BioroboticsLab/hiveopolis_dance_robot/README.md

# Hiveopolis Dance Robot

This will list the documents and files for constructing the bee robot.
