BioroboticsLab/hiveopolis_dance_robot/BeeRobot/Bee Robot (2022 Design)/Hardware(Mechanical)/Dummy/Description CAD files Robo Dummy.docx

Rounded End Dummy:

- Three files were included, namely bee-artificial_v5 v4.stl, .step, and .f3z (a fusion archive file).
- The .stl file can be used for 3d printing the specified dummy.
- Printing instructions:
  - The dummy is printed with flexible materials, namely TPU95 or other more flexible or rigid versions of this thermoplastic material.
  - The dummy should be printed with its body on the build plate for better results.

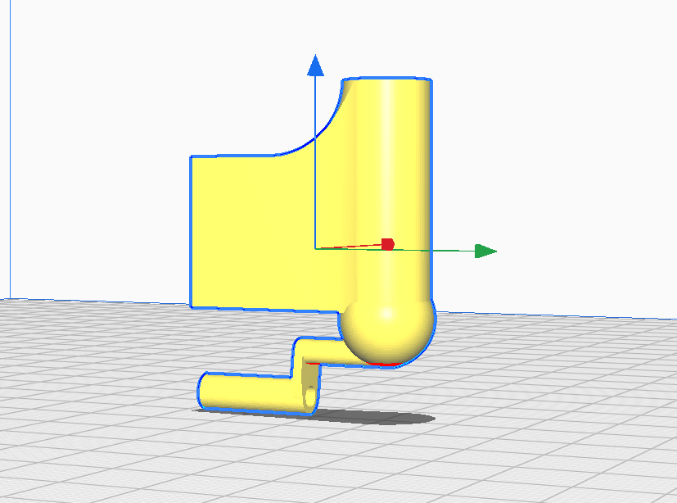
[picture p1: figure]

  - Tree support was seen as promising and easily detachable support.

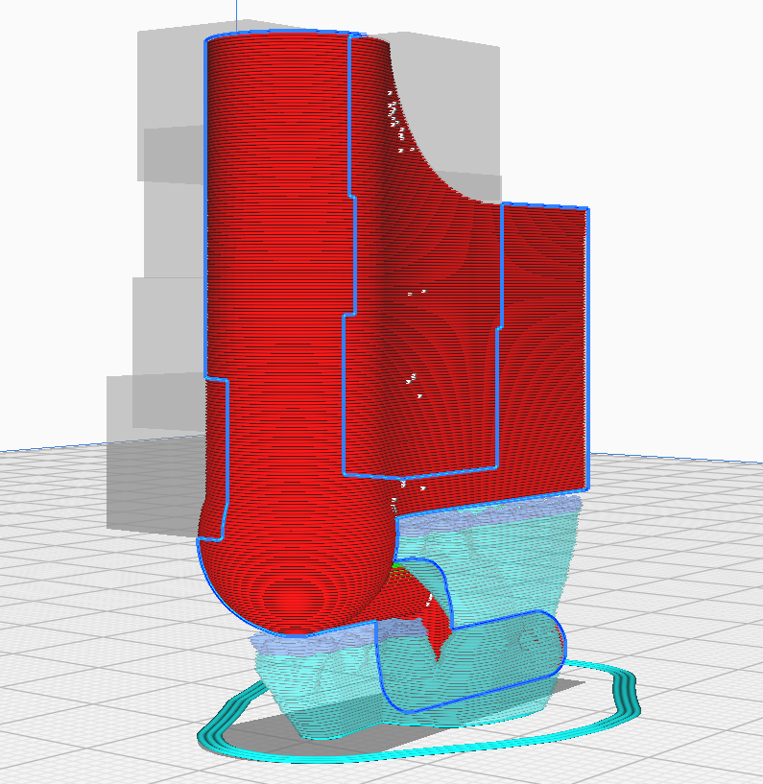
[picture p2: figure]

Flat End Dummy:

- Three files were included, namely bee-artificial_v6 v1.stl, .step, and .f3z (a fusion archive file).
- The .stl file can be used for 3d printing the specified dummy.
- Printing instructions:
  - The dummy is printed with flexible materials, namely TPU95 or other more flexible or rigid versions of this thermoplastic material.
