BioroboticsLab/hiveopolis_dance_robot/BeeRobot/Bee Robot (2022 Design)/Bill Materials Combined.xlsx

Qty | Short Description | Link | Seller | Used for
4 | Linear bearing LM8UU / SP DR 8 mm Suitable for: velleman K8200 LM8UU / SP | https://www.conrad.de/de/p/linearlager-lm8uu-sp-dr-8-mm-passend-fuer-velleman-k8200-lm8uu-sp-1013428.html | Conrad | Body
4 | Reely linear ball bearing inner diameter: 6 mm outer diameter: 12 mm | https://www.conrad.de/de/p/reely-linearkugellager-innen-durchmesser-6-mm-aussen-durchmesser-12-mm-221974.html | Conrad | Body
4 | Silver steel shaft Reely (Ø x L) 8 mm x 500 mm | https://www.conrad.de/de/p/silberstahl-welle-reely-x-l-8-mm-x-500-mm-237205.html | Conrad | Body
4 | Panasonic microswitch | https://www.conrad.de/de/p/panasonic-mikroschalter-asq10617j-30-v-dc-0-1-a-1-x-ein-ein-tastend-1-st-702264.html | Conrad | Body
3 | Silver steel shaft Reely (Ø x L) 6 mm x 500 mm | https://www.conrad.com/p/silver-steel-shaft-reely-x-l-6-mm-x-500-mm-237086 | Conrad | Body
20 | Kemet 100 nF cap | https://www.conrad.de/de/p/kemet-c322c104k5r5ta-keramik-kondensator-radial-bedrahtet-100-nf-50-v-10-l-x-b-x-h-5-08-x-3-18-x-5-84-mm-1-st-1420319.html | Conrad | Keypad
10 | Header 2 | https://www.conrad.de/de/p/econ-connect-buchsenleiste-standard-anzahl-reihen-1-polzahl-je-reihe-2-blg1x2-1-st-1492277.html | Conrad | Main Board
10 | Header 3 | https://www.conrad.de/de/p/econ-connect-buchsenleiste-standard-anzahl-reihen-1-polzahl-je-reihe-3-blg1x3-1-st-1492300.html | Conrad | Main Board
10 | Header 5 | https://www.conrad.de/de/p/econ-connect-buchsenleiste-standard-anzahl-reihen-1-polzahl-je-reihe-5-blg1x5-1-st-1492291.html | Conrad | Main Board
10 | Header 8 | https://www.conrad.de/de/p/econ-connect-buchsenleiste-standard-anzahl-reihen-1-polzahl-je-reihe-8-blg1x8-1-st-1492302.html | Conrad | Main Board
10 | Header 16 | https://www.conrad.de/de/p/econ-connect-buchsenleiste-standard-anzahl-reihen-1-polzahl-je-reihe-16-blg1x16-1-st-1492274.html | Conrad | Main Board
10 | Header 20 | https://www.conrad.de/de/p/econ-connect-buchsenleiste-standard-anzahl-reihen-1-polzahl-je-reihe-20-blg1x20-1-st-1492278.html | Conrad | Main Board
1 | ESP32-DEVKITC-32E | https://www.digikey.de/en/products/detail/espressif-systems/ESP32-DEVKITC-32E/12091810 | Digikey | Main Board
1 | ESP32-DEVKITC-32E | https://www.digikey.de/en/products/detail/espressif-systems/ESP32-DEVKITC-32E/12091810 | Digikey | Keypad
2 | DFR0555 | https://www.digikey.de/en/products/detail/dfrobot/DFR0555/9356340 | Digikey | Keypad
12 | 5511M1X | https://www.digikey.de/en/products/detail/e-switch/5511M1X/271586 | Digikey | Keypad
2 | Stepper LSA421 | https://en.nanotec.com/products/2792-lsa421s14-a-uiev-152 | Nanotec | Body
2 | CABLE-EH06 | https://en.nanotec.com/products/1393-zk-jst-ehr-6-05m-s-motor-cable-05m | Nanotec | Body
1 | LSNUT-AAAA-UECB – THREADED NUT | https://en.nanotec.com/products/2840-lsnut-aaaa-uecb-threaded-nut | Nanotec | Body
1 | LSNUT-AEAE-UIEV | https://en.nanotec.com/products/2800-lsnut-aeae-uiev-axial-anti-backlash-threaded-nut-with-helical-spring | Nanotec | Body
1 | NANOLUBE-50G – BEARING GREASE | https://en.nanotec.com/products/2389-nanolube-50g-bearing-grease | Nanotec | Body
1 | ENCODER CABLE NOE, 0.5M | https://en.nanotec.com/products/1216-zk-noe1-10-500-s-encoder-cable-noe-05m | Nanotec | Body
1 | LSA201S06-B-UECB-102 with encoder NOE1-05-B14 (5 mm) | https://en.nanotec.com/products/product-configurator/2849?cHash=9072cd3baa13280dc13a2a933e44916d | Nanotec | Body
1 | TEENSY LC H Teensy LC, USB, mit Header | https://www.reichelt.de/teensy-lc-usb-mit-header-teensy-lc-h-p318646.html?&nbc=1 | reichelt | Main Board
20 | AKL 349-02 Anschlussklemmensystem 2-pol, RM5,0 | https://www.reichelt.de/de/de/anschlussklemmensystem-2-pol-rm5-0-akl-349-02-p36665.html?nbc=1&r=1 | reichelt | Main Board
20 | SLGW 902 5 Stiftleiste, lötbar, 2-pol, RM 5,00 | https://www.reichelt.de/stiftleiste-loetbar-2-pol-rm-5-00-slgw-902-5-p159599.html?nbc=1 | reichelt | Main Board
20 | AKL 330-04 Wannenstecker für AKL 349, 4-pol, RM5,0 | https://www.reichelt.de/wannenstecker-fuer-akl-349-4-pol-rm5-0-akl-330-04-p36681.html | reichelt | Main Board
20 | AKL 349-04 Anschlussklemmensystem 4-pol, RM5,0 | https://www.reichelt.de/anschlussklemmensystem-4-pol-rm5-0-akl-349-04-p36667.html?nbc=1 | reichelt | Main Board
1 | Pololu 24V Step-Up/Step-Down Voltage Regulator S18V20F24 | https://www.exp-tech.de/module/spannungsregler/9318/pololu-24v-step-up/step-down-voltage-regulator-s18v20f24 | exptech | Main Board
3 | Pololu A4988 Stepper Motor Driver Carrier | https://www.exp-tech.de/motoren/motorsteuerung/schrittmotor-treiber/4795/pololu-a4988-stepper-motor-driver-carrier-black-edition | exptech | Main Board
1 | 5V 1A STEP-DOWN D24V10F5 POLOLU | https://www.exp-tech.de/module/spannungsregler/6268/pololu-5v-1a-step-down-voltage-regulator-d24v10f5 | exptech | Main Board
