BioroboticsLab/hiveopolis_dance_robot/AdditionalSetup/Hardware/LightandCameraMount/Mount_Raspberry_Pi_CameraFRONT.stl

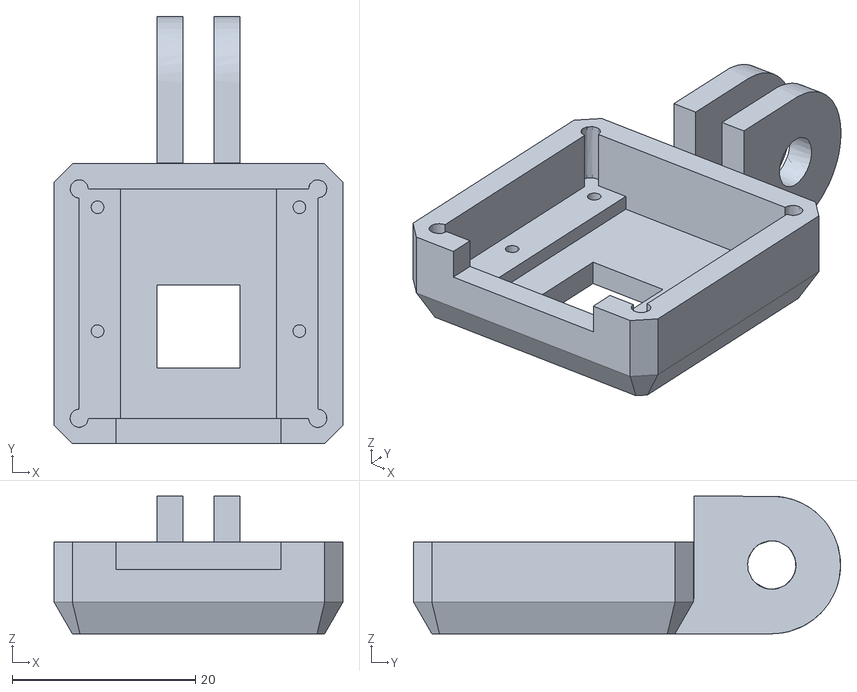
[picture p3: CAD file, 2023-08-09]
AdditionalSetup/Hardware/LightandCameraMount/Mount_Raspberry_Pi_CameraFRONT.stl
31.5 x 46.5 x 15.0
