BioroboticsLab/hiveopolis_dance_robot/AdditionalSetup/Hardware/Robot_ITEM_Fixture/3D_models/experment_setup/Robot_ITEM_Fixture.STEP

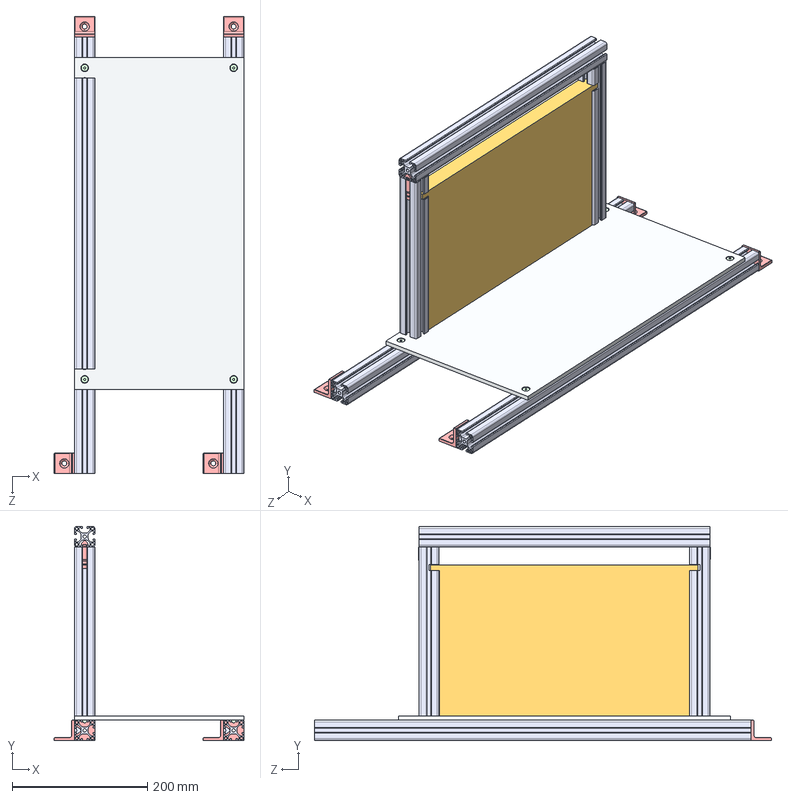
[picture p4: CAD file, 2023-08-09]
AdditionalSetup/Hardware/Robot_ITEM_Fixture/3D_models/experment_setup/Robot_ITEM_Fixture.STEP
280.0 x 316.0 x 675.0 mm
0041906_Profil_6_30x30_250 x 2
0041906_Profil_6_30x30_430
0041906_Profil_6_30x30_645 x 2
Al-Platte
Dummy
0067775_Winkel_6_30 x 4
0041971_Automatik-Verbindungssatz_6 x 2
0068094_Befestigungssatz_6 x 2
0068092_Befestigungssatz_5 x 4
