BioroboticsLab/hiveopolis_dance_robot/BeeRobot/Bee Robot (2022 Design)/Hardware(Mechanical)/Dance Robot Body/CAD files/carridgedesignv24_FRAME DESIGN_Part1.stl

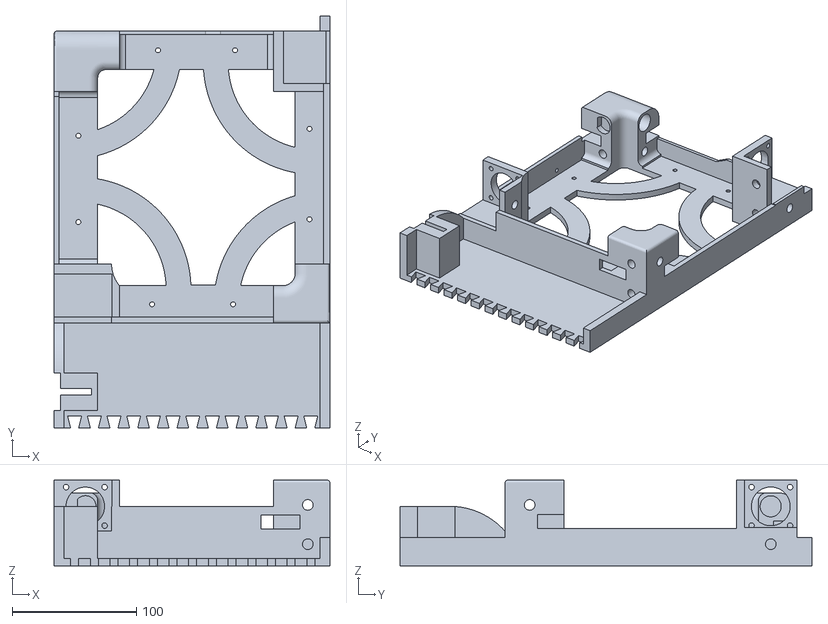
[picture p5: CAD file, 2023-08-09]
BeeRobot/Bee Robot (2022 Design)/Hardware(Mechanical)/Dance Robot Body/CAD files/carridgedesignv24_FRAME DESIGN_Part1.stl
222.0 x 331.5 x 69.1
