BioroboticsLab/hiveopolis_dance_robot/BeeRobot/Bee Robot (2022 Design)/Hardware(Mechanical)/Dummy/Flat End Dummy/bee_artificial_v6 v1.step

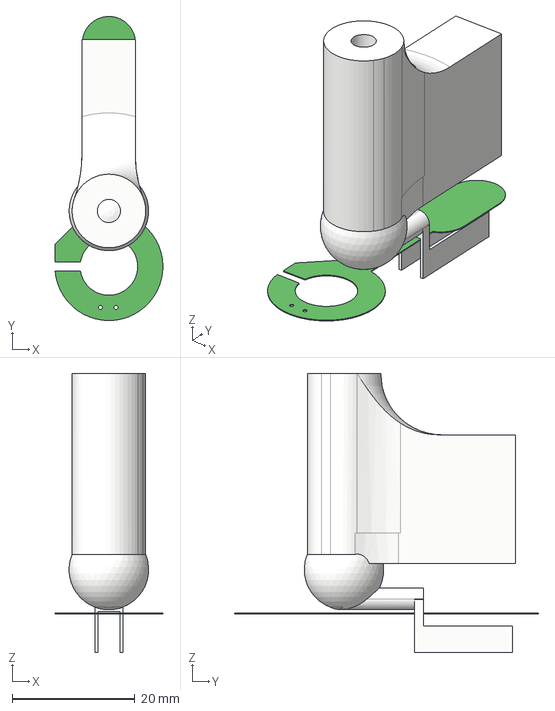
[picture p6: CAD file, 2023-08-09]
BeeRobot/Bee Robot (2022 Design)/Hardware(Mechanical)/Dummy/Flat End Dummy/bee_artificial_v6 v1.step
17.6 x 49.6 x 45.5 mm
