BioroboticsLab/hiveopolis_dance_robot/BeeRobot/Bee Robot (2022 Design)/Hardware(Mechanical)/Dummy/Rounded End Dummy/bee_artificial_v5 v4.step

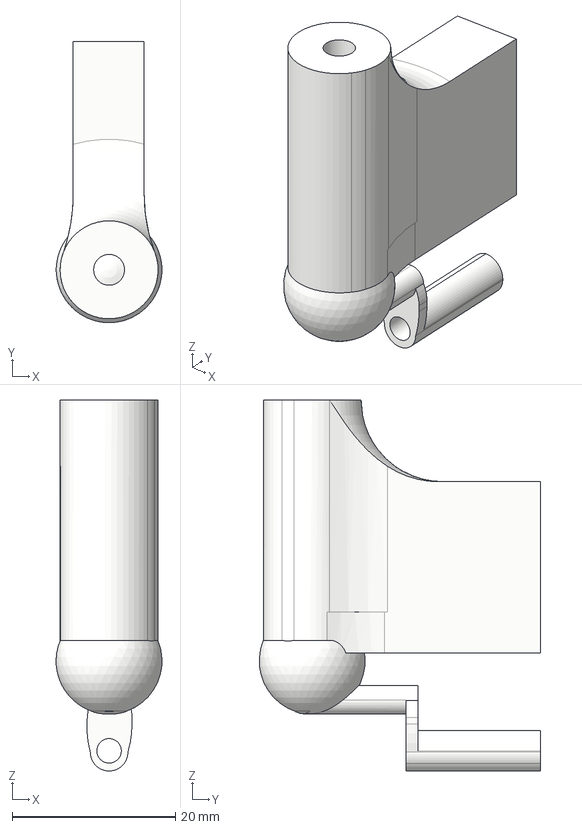
[picture p7: CAD file, 2023-08-09]
BeeRobot/Bee Robot (2022 Design)/Hardware(Mechanical)/Dummy/Rounded End Dummy/bee_artificial_v5 v4.step
13.0 x 34.5 x 45.5 mm
