BioroboticsLab/hiveopolis_dance_robot/AdditionalSetup/Hardware/LightandCameraMount/Mount_Arm_Straight_30mm.STL

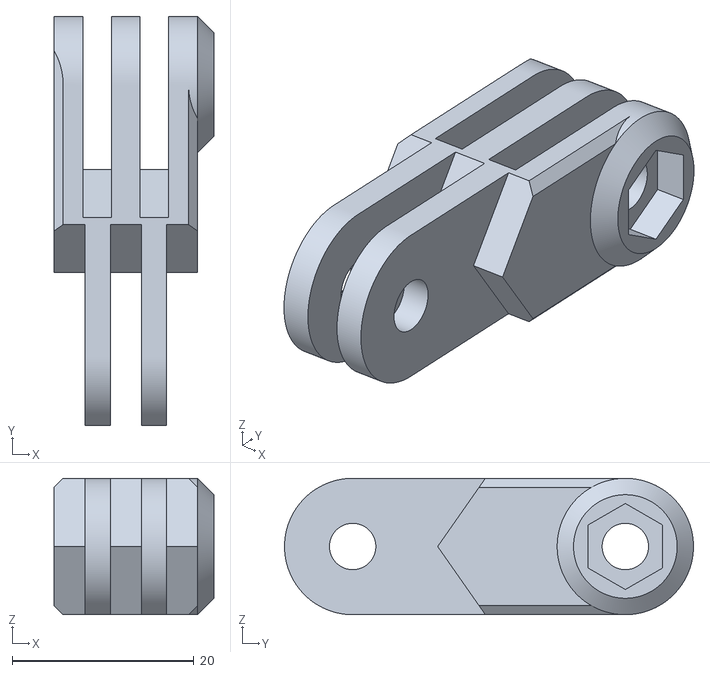
[picture p9: CAD file, 2023-08-09]
AdditionalSetup/Hardware/LightandCameraMount/Mount_Arm_Straight_30mm.STL
17.6 x 45.0 x 15.0
