BioroboticsLab/hiveopolis_dance_robot/BeeRobot/Bee Robot (2022 Design)/Hardware(Mechanical)/Dance Robot Body/CAD files/carridgedesignv24_FRAME DESIGN v14.step

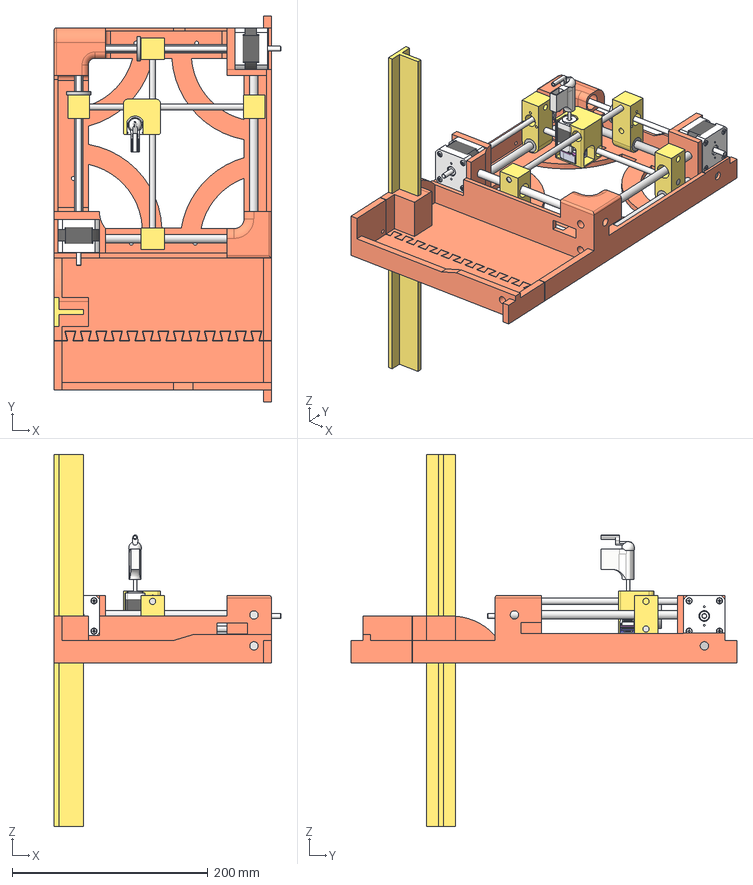
[picture p10: CAD file, 2023-08-09]
BeeRobot/Bee Robot (2022 Design)/Hardware(Mechanical)/Dance Robot Body/CAD files/carridgedesignv24_FRAME DESIGN v14.step
231.8 x 394.0 x 380.0 mm
LSA421S14-B-UIEV-152 x 2
LSNUT x 2
bee_artificial_v3
NOE1
LSA201S06-B-UECB-102
