BioroboticsLab/hiveopolis_dance_robot/BeeRobot/Bee Robot (2022 Design)/Hardware(Mechanical)/Keypad/CAD Files/pcb_keypad v5.step

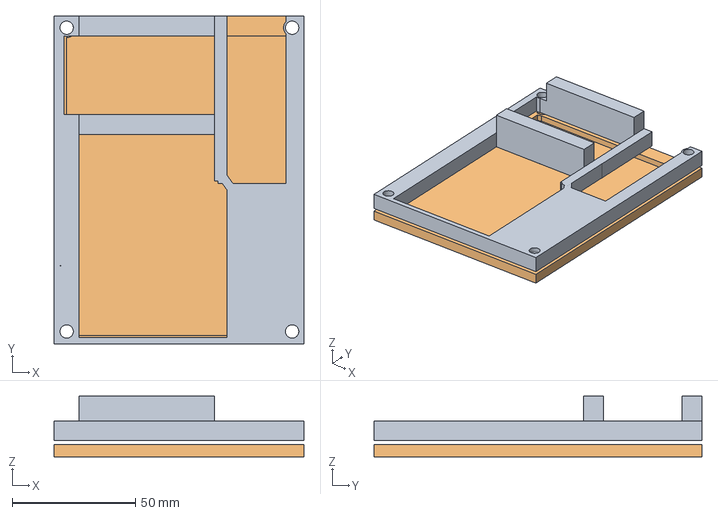
[picture p11: CAD file, 2023-08-09]
BeeRobot/Bee Robot (2022 Design)/Hardware(Mechanical)/Keypad/CAD Files/pcb_keypad v5.step
101.3 x 133.0 x 24.6 mm
