BioroboticsLab/hiveopolis_dance_robot/AdditionalSetup/Hardware/LightandCameraMount/Mount_Flat_Fix_Light.stl

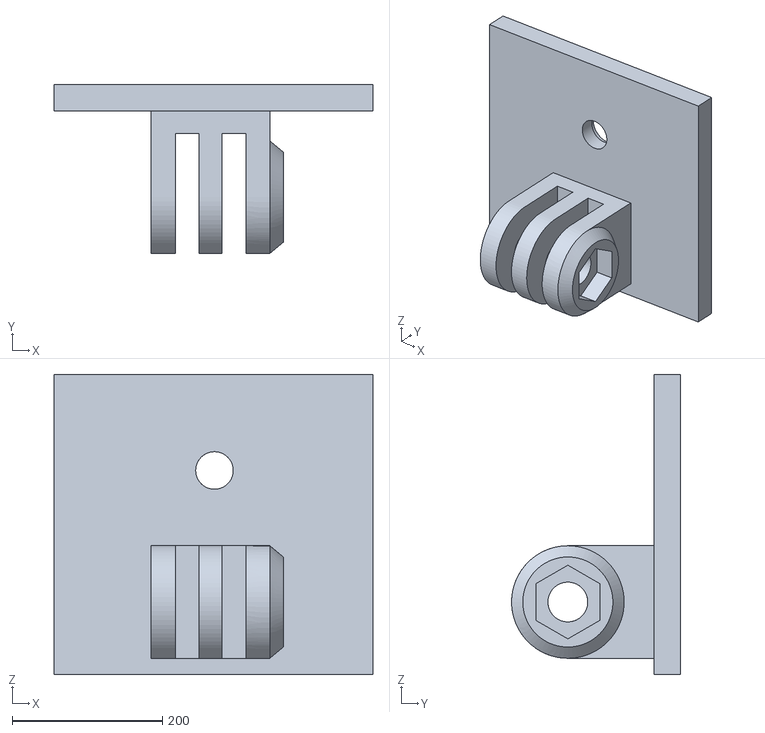
[picture p12: CAD file, 2023-08-09]
AdditionalSetup/Hardware/LightandCameraMount/Mount_Flat_Fix_Light.stl
425.0 x 225.0 x 400.0
