BioroboticsLab/hiveopolis_dance_robot/BeeRobot/Bee Robot (2022 Design)/Hardware(Mechanical)/Dance Robot Body/CAD files/carridgedesignv24_FRAME DESIGN_Part2.stl

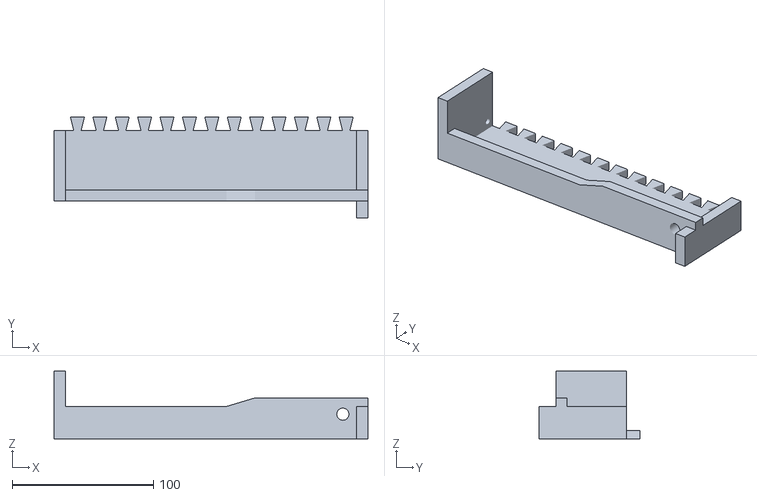
[picture p13: CAD file, 2023-08-09]
BeeRobot/Bee Robot (2022 Design)/Hardware(Mechanical)/Dance Robot Body/CAD files/carridgedesignv24_FRAME DESIGN_Part2.stl
222.0 x 71.7 x 48.0
