BioroboticsLab/hiveopolis_dance_robot/BeeRobot/Bee Robot (2022 Design)/Hardware(Mechanical)/Keypad/CAD Files/Keypad_UP_Cover.stl

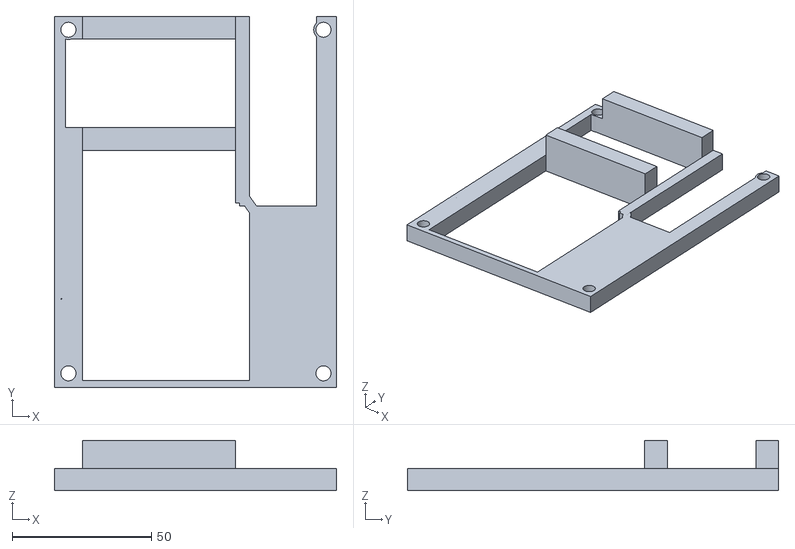
[picture p14: CAD file, 2023-08-09]
BeeRobot/Bee Robot (2022 Design)/Hardware(Mechanical)/Keypad/CAD Files/Keypad_UP_Cover.stl
101.3 x 133.0 x 18.0
