BioroboticsLab/hiveopolis_dance_robot/AdditionalSetup/Hardware/LightandCameraMount/M5_Knob_Short.stl

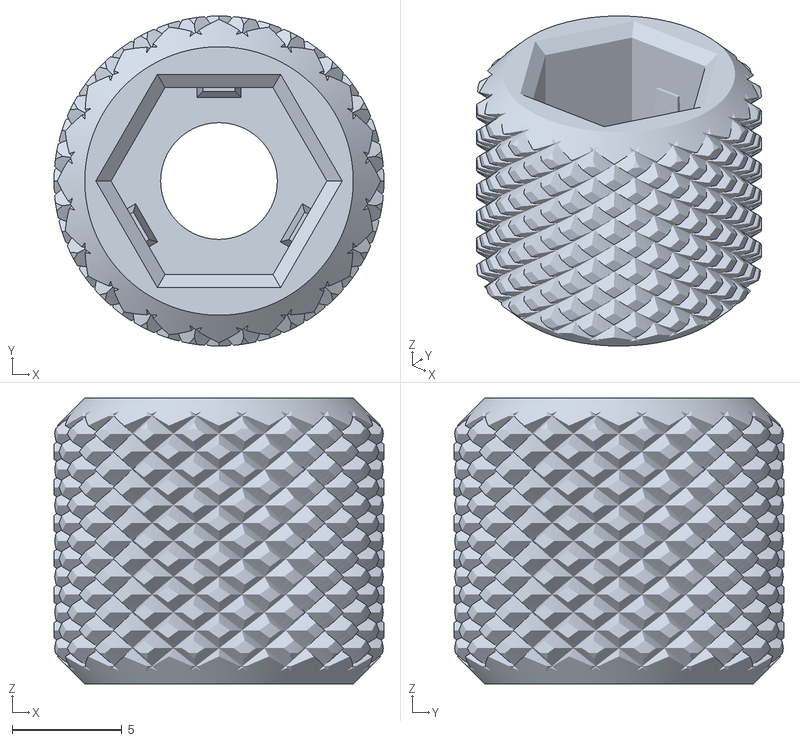
[picture p15: CAD file, 2023-08-09]
AdditionalSetup/Hardware/LightandCameraMount/M5_Knob_Short.stl
15.0 x 15.0 x 13.0
