BioroboticsLab/hiveopolis_dance_robot/BeeRobot/Bee Robot (2022 Design)/Hardware(Mechanical)/Dance Robot Body/CAD files/ShaftholdersAndGuide.stl

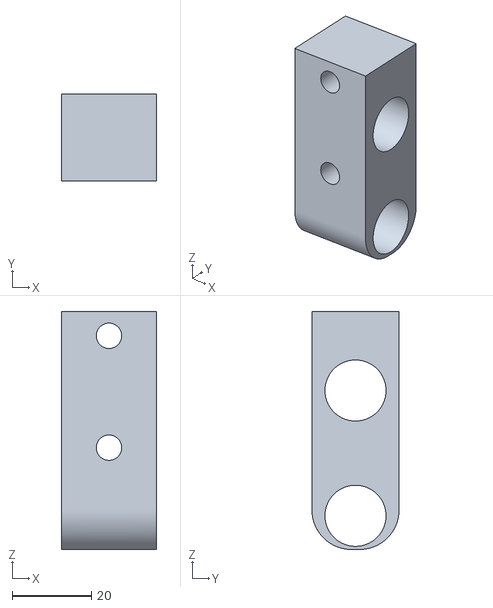
[picture p16: CAD file, 2023-08-09]
BeeRobot/Bee Robot (2022 Design)/Hardware(Mechanical)/Dance Robot Body/CAD files/ShaftholdersAndGuide.stl
24.0 x 22.0 x 60.0
