BioroboticsLab/hiveopolis_dance_robot/AdditionalSetup/Hardware/LightandCameraMount/Mount_Flat_Fix_Item.stl

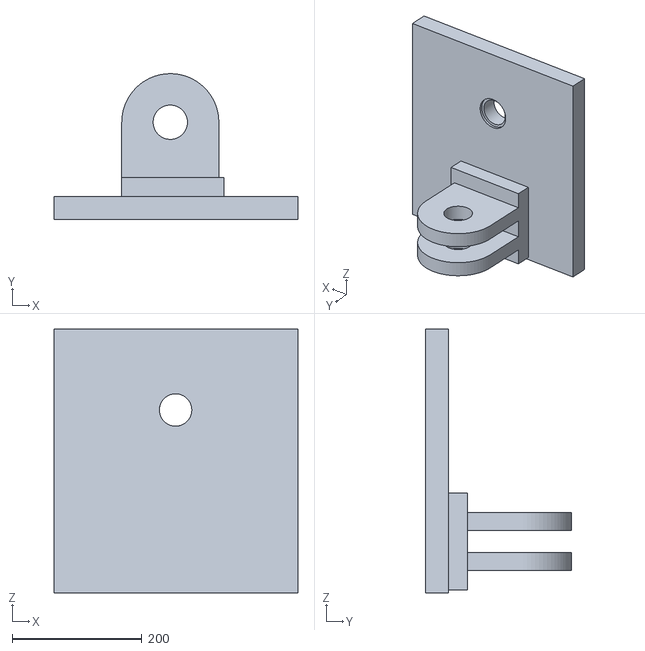
[picture p17: CAD file, 2023-08-09]
AdditionalSetup/Hardware/LightandCameraMount/Mount_Flat_Fix_Item.stl
376.7 x 225.0 x 407.7
