BioroboticsLab/hiveopolis_dance_robot/BeeRobot/Bee Robot (2022 Design)/Hardware(Mechanical)/Dance Robot Body/CAD files/centerv4 v9.step

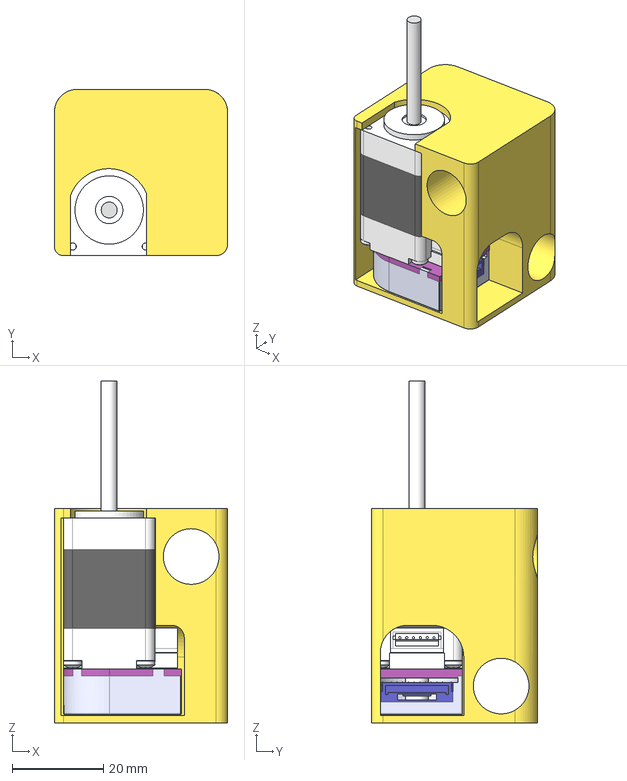
[picture p18: CAD file, 2023-08-09]
BeeRobot/Bee Robot (2022 Design)/Hardware(Mechanical)/Dance Robot Body/CAD files/centerv4 v9.step
38.0 x 36.5 x 75.0 mm
NOE1
LSA201S06-B-UECB-102
