BioroboticsLab/hiveopolis_dance_robot/AdditionalSetup/Hardware/LightandCameraMount/Mount_Arm_Straight_60mm.STL

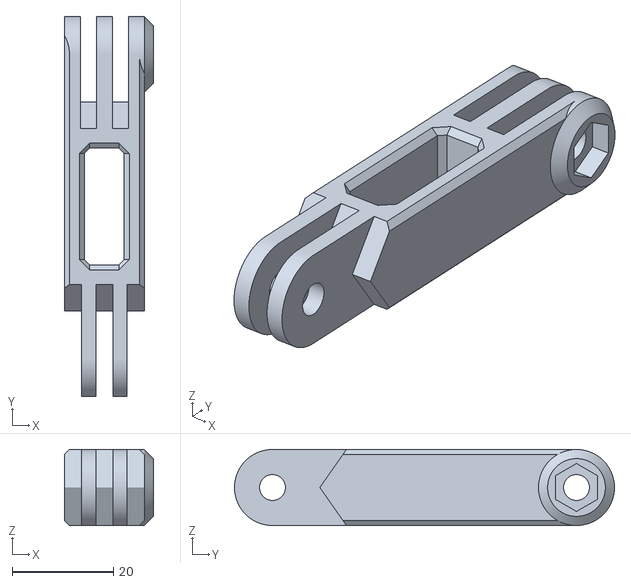
[picture p19: CAD file, 2023-08-09]
AdditionalSetup/Hardware/LightandCameraMount/Mount_Arm_Straight_60mm.STL
17.6 x 75.0 x 15.0
