BioroboticsLab/hiveopolis_dance_robot/BeeRobot/Bee Robot (2022 Design)/Hardware(Mechanical)/Dance Robot Body/CAD files/carridgedesignv24_FRAME DESIGN_Part3.stl

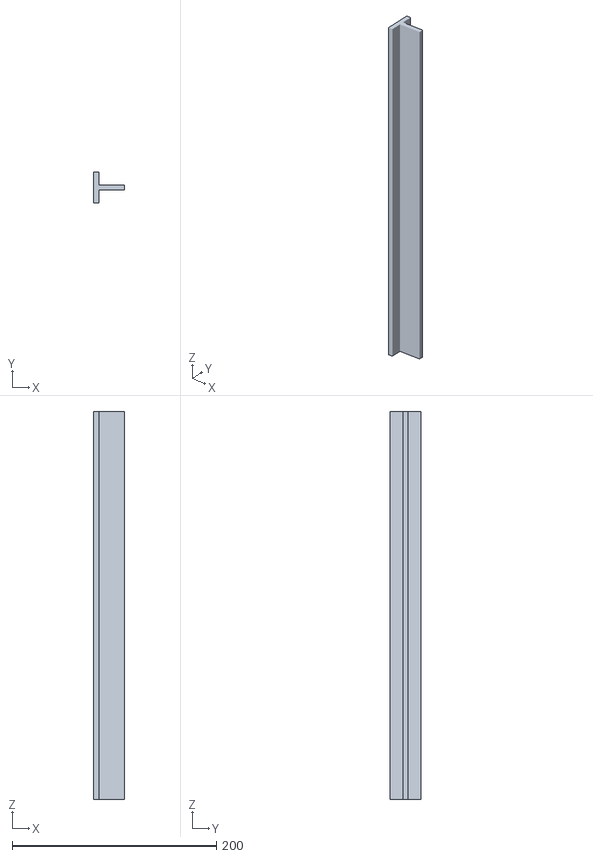
[picture p20: CAD file, 2023-08-09]
BeeRobot/Bee Robot (2022 Design)/Hardware(Mechanical)/Dance Robot Body/CAD files/carridgedesignv24_FRAME DESIGN_Part3.stl
30.0 x 30.0 x 380.0
