BioroboticsLab/hiveopolis_dance_robot/AdditionalSetup/Hardware/LightandCameraMount/Axis_Change_Connector.stl

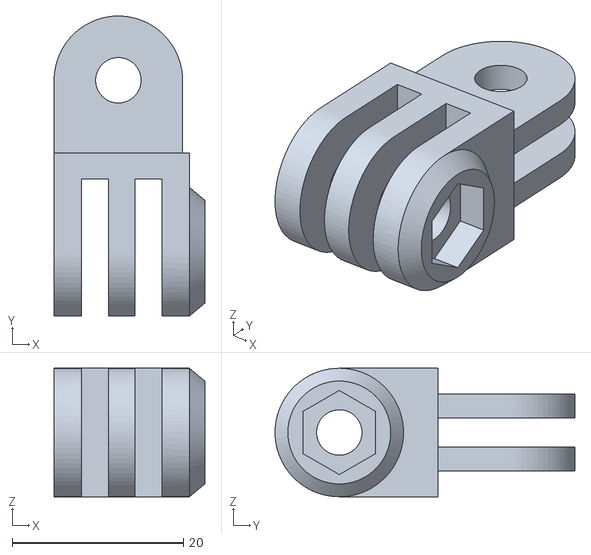
[picture p21: CAD file, 2023-08-09]
AdditionalSetup/Hardware/LightandCameraMount/Axis_Change_Connector.stl
17.6 x 35.0 x 15.0
