BioroboticsLab/hiveopolis_dance_robot/(list of files, cad)

Other CAD files:
BeeRobot/Bee Robot (2022 Design)/Hardware(Mechanical)/Dance Robot Body/CAD files/carridgedesignv24_FRAME DESIGN v14.f3z
BeeRobot/Bee Robot (2022 Design)/Hardware(Mechanical)/Dance Robot Body/CAD files/centerv4 v9.f3z
BeeRobot/Bee Robot (2022 Design)/Hardware(Mechanical)/Dance Robot Body/CAD files/centerv4 v9.stl
BeeRobot/Bee Robot (2022 Design)/Hardware(Mechanical)/Dummy/Flat End Dummy/bee_artificial_v6 v1.f3z
BeeRobot/Bee Robot (2022 Design)/Hardware(Mechanical)/Dummy/Flat End Dummy/bee_artificial_v6 v1.stl
BeeRobot/Bee Robot (2022 Design)/Hardware(Mechanical)/Dummy/Rounded End Dummy/bee_artificial_v5 v4.f3z
BeeRobot/Bee Robot (2022 Design)/Hardware(Mechanical)/Dummy/Rounded End Dummy/bee_artificial_v5 v4.stl
