BioroboticsLab/hiveopolis_dance_robot/BeeRobot/Bee Robot (2022 Design)/Hardware(Mechanical)/Keypad/Description of Files and Instructions for keypad.docx

- Folder Robo_Keypad_PCB
  - Use the latest version as labeled by the folder name, currently being “v1.2”.
  - The files need to access using Autodesk Eagle software.
- Folder Keypad_Code
  - The file Keypad_Main.ino is the main file and can be opened using Arduino IDE and flashed onto the keypad control board (ESP32 on the keypad)
  - The other files are dependencies of the main file.
- Folder CAD Files
  - The files in this folder include CAD files for the covers of the keypad.
  - The .step and .f3d are editable files that can be opened and edited using Fusion360 software.
  - The two other .stl files (Keypad_UP_Cover and Keypad_D_Cover) are files used for 3D printing the cover for the keypad.
