BioroboticsLab/hiveopolis_dance_robot/(list of files, drawings)

Other design files:
BeeRobot/Bee Robot (2022 Design)/Hardware(Electronic)/Altium Designer/WingDriverv1/PCB1.PcbDoc
BeeRobot/Bee Robot (2022 Design)/Hardware(Electronic)/Altium Designer/WingDriverv1/PcbLib1.PcbLib
BeeRobot/Bee Robot (2022 Design)/Hardware(Electronic)/Altium Designer/WingDriverv1/Sheet1.SchDoc
BeeRobot/Bee Robot (2022 Design)/Hardware(Electronic)/Altium Designer/WingDriverv1/WingDriverv1.PrjPcb
