BioroboticsLab/hiveopolis_dance_robot/BeeRobot/Bee Robot (2022 Design)/Hardware(Electronic)/Autodesk Eagle/BeeRobot_Control_Board/v2.1/Hiveopolis.brd

## EAGLE design BeeRobot/Bee Robot (2022 Design)/Hardware(Electronic)/Autodesk Eagle/BeeRobot_Control_Board/v2.1/Hiveopolis.brd (2023-08-09, an earlier design)

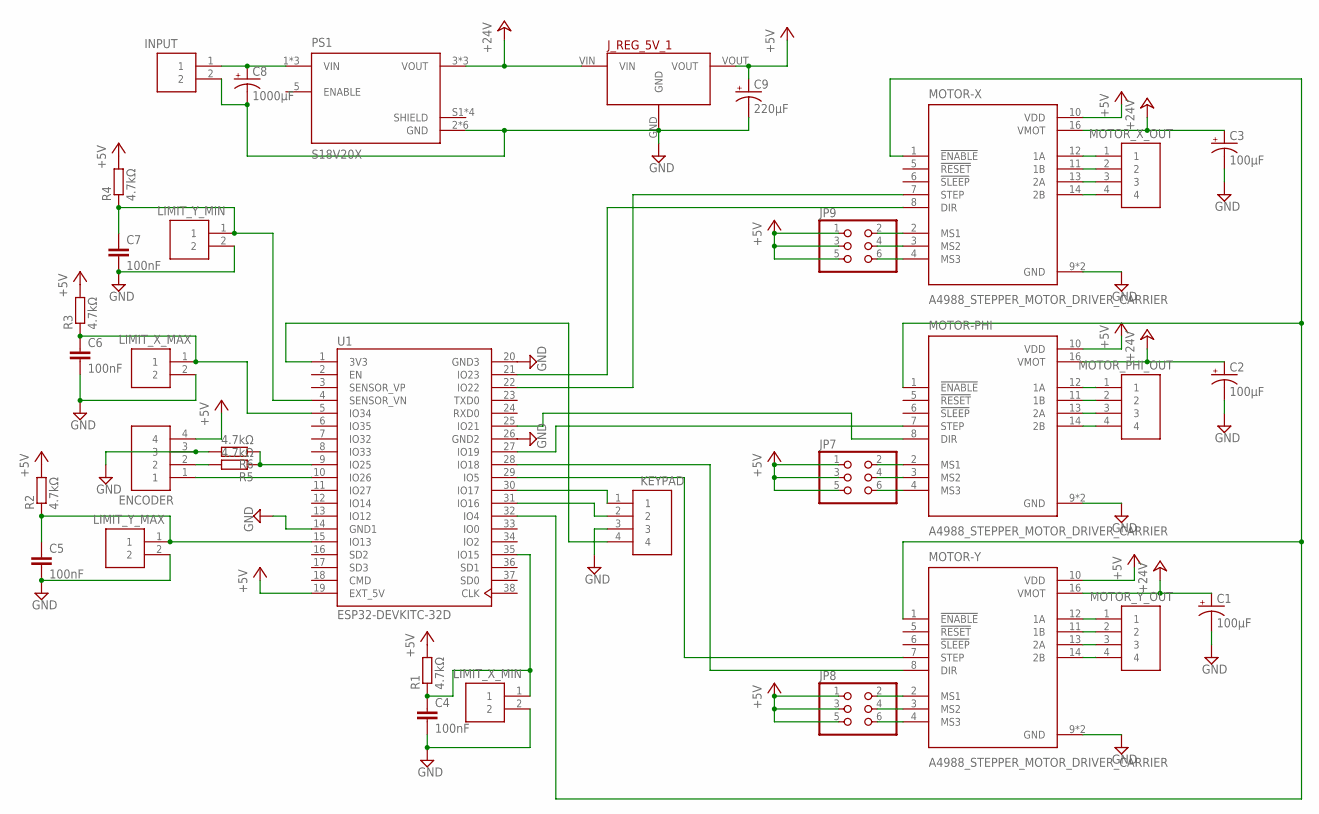
[picture p22: schematic Hiveopolis.sch]

Parts:
C1, C2, C3: 100µF; E5-5
C4, C5, C6, C7: 100nF; C025-024X044
C8: 1000µF; E5-10,5
C9: 220µF; E5-8,5
ENCODER: S4B-XH-A(LF)(SN); HDR-04/RA
INPUT: S2B-XH-A(LF)(SN); HDR-02/RA
JP7, JP8, JP9: PINHD-2X3; 2X03
J_REG_5V_1: 5V_VOLTAGE_REGULATOR
KEYPAD: S4B-XH-A(LF)(SN); HDR-04/RA
LIMIT_X_MAX: S2B-XH-A(LF)(SN); HDR-02/RA
LIMIT_X_MIN: S2B-XH-A(LF)(SN); HDR-02/RA
LIMIT_Y_MAX: S2B-XH-A(LF)(SN); HDR-02/RA
LIMIT_Y_MIN: S2B-XH-A(LF)(SN); HDR-02/RA
MOTOR-PHI: A4988_STEPPER_MOTOR_DRIVER_CARRIER; MODULE_A4988_STEPPER_MOTOR_DRIVER_CARRIER
MOTOR-X: A4988_STEPPER_MOTOR_DRIVER_CARRIER; MODULE_A4988_STEPPER_MOTOR_DRIVER_CARRIER
MOTOR-Y: A4988_STEPPER_MOTOR_DRIVER_CARRIER; MODULE_A4988_STEPPER_MOTOR_DRIVER_CARRIER
MOTOR_PHI_OUT: S4B-XH-A(LF)(SN); HDR-04/RA
MOTOR_X_OUT: S4B-XH-A(LF)(SN); HDR-04/RA
MOTOR_Y_OUT: S4B-XH-A(LF)(SN); HDR-04/RA
PS1: S18V20X; CONV_S18V20X
R1, R2, R3, R4, R5, R6: 4.7kΩ; 0207/10
U1: ESP32-DEVKITC-32D; MODULE_ESP32-DEVKITC-32D

Connections:
+5V: C9.+, ENCODER.4, JP7.1, JP7.3, JP7.5, JP8.1, JP8.3, JP8.5, JP9.1, JP9.3, JP9.5, J_REG_5V_1.VOUT, MOTOR-PHI.10 (VDD), MOTOR-X.10 (VDD), MOTOR-Y.10 (VDD), R1.2, R2.2, R3.2, R4.2, U1.19 (EXT_5V)
+24V: C1.+, C2.+, C3.+, J_REG_5V_1.VIN, MOTOR-PHI.16 (VMOT), MOTOR-X.16 (VMOT), MOTOR-Y.16 (VMOT), PS1.3 (VOUT), PS1.10 (VOUT), PS1.11 (VOUT)
GND: C1.-, C2.-, C3.-, C4.2, C5.2, C6.2, C7.2, C8.-, C9.-, ENCODER.3, INPUT.2, J_REG_5V_1.GND, KEYPAD.3, LIMIT_X_MAX.2, LIMIT_X_MIN.2, LIMIT_Y_MAX.2, LIMIT_Y_MIN.2, MOTOR-PHI.9 (GND), MOTOR-PHI.15 (GND), MOTOR-X.9 (GND), MOTOR-X.15 (GND), MOTOR-Y.9 (GND), MOTOR-Y.15 (GND), PS1.2 (GND), PS1.4 (GND), PS1.8 (GND), PS1.9 (GND), PS1.12 (GND), PS1.13 (GND), R6.2, U1.14 (GND1), U1.20 (GND3), U1.26 (GND2)
unnamed: MOTOR-X.7 (STEP), U1.22 (IO22)
unnamed: MOTOR-X.8 (DIR), U1.21 (IO23)
unnamed: ENCODER.1, U1.10 (IO26)
unnamed: JP9.2, MOTOR-X.2 (MS1)
unnamed: MOTOR-PHI.8 (DIR), U1.25 (IO21)
unnamed: MOTOR-Y.7 (STEP), U1.29 (IO5)
unnamed: C5.1, LIMIT_Y_MAX.1, R2.1, U1.15 (IO13)
unnamed: MOTOR-PHI.7 (STEP), U1.27 (IO19)
unnamed: MOTOR-X.12 (1A), MOTOR_X_OUT.1
unnamed: MOTOR-X.11 (1B), MOTOR_X_OUT.2
unnamed: MOTOR-X.13 (2A), MOTOR_X_OUT.3
unnamed: MOTOR-X.14 (2B), MOTOR_X_OUT.4
unnamed: JP9.4, MOTOR-X.3 (MS2)
unnamed: JP9.6, MOTOR-X.4 (MS3)
unnamed: JP7.2, MOTOR-PHI.2 (MS1)
unnamed: JP7.4, MOTOR-PHI.3 (MS2)
unnamed: MOTOR-PHI.12 (1A), MOTOR_PHI_OUT.1
unnamed: MOTOR-PHI.11 (1B), MOTOR_PHI_OUT.2
unnamed: MOTOR-PHI.13 (2A), MOTOR_PHI_OUT.3
unnamed: MOTOR-PHI.14 (2B), MOTOR_PHI_OUT.4
unnamed: MOTOR-Y.12 (1A), MOTOR_Y_OUT.1
unnamed: MOTOR-Y.11 (1B), MOTOR_Y_OUT.2
unnamed: MOTOR-Y.13 (2A), MOTOR_Y_OUT.3
unnamed: MOTOR-Y.14 (2B), MOTOR_Y_OUT.4
unnamed: JP7.6, MOTOR-PHI.4 (MS3)
unnamed: JP8.2, MOTOR-Y.2 (MS1)
unnamed: C6.1, LIMIT_X_MAX.1, R3.1, U1.5 (IO34)
unnamed: ENCODER.2, R5.2
unnamed: KEYPAD.1, U1.30 (IO17)
unnamed: C7.1, LIMIT_Y_MIN.1, R4.1, U1.4 (SENSOR_VN)
unnamed: JP8.4, MOTOR-Y.3 (MS2)
unnamed: JP8.6, MOTOR-Y.4 (MS3)
unnamed: KEYPAD.2, U1.31 (IO16)
unnamed: KEYPAD.4, U1.1 (3V3)
unnamed: C4.1, LIMIT_X_MIN.1, R1.1, U1.35 (IO15)
unnamed: MOTOR-PHI.1 (!ENABLE), MOTOR-X.1 (!ENABLE), MOTOR-Y.1 (!ENABLE), U1.32 (IO4)
unnamed: R5.1, R6.1, U1.9 (IO25)
unnamed: C8.+, INPUT.1, PS1.1 (VIN), PS1.6 (VIN), PS1.7 (VIN)
unnamed: MOTOR-Y.8 (DIR), U1.28 (IO18)

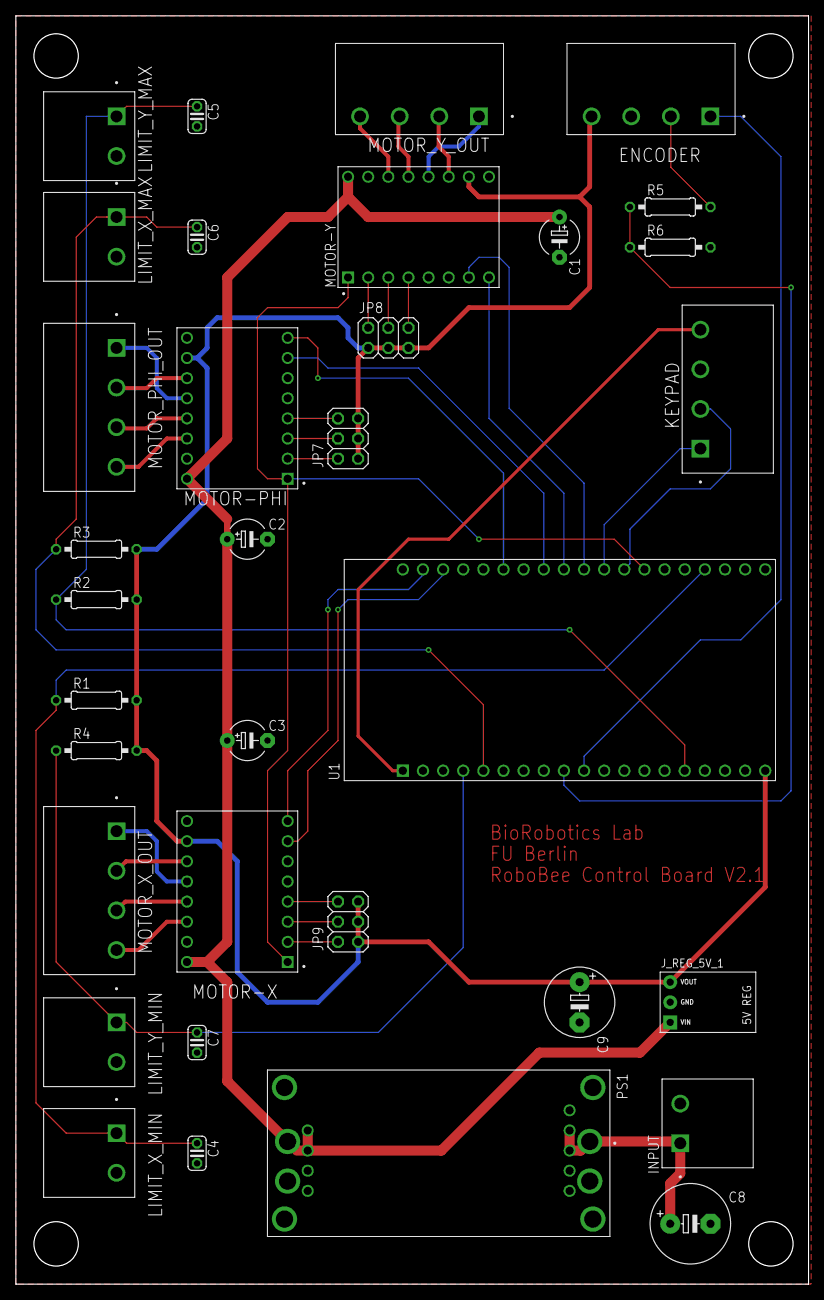
[picture p23: board Hiveopolis.brd from above]

Board: 2 copper layers, 100.0 x 160.0 mm, 34 parts (0 on the bottom side), 42 nets.
