BioroboticsLab/hiveopolis_dance_robot/BeeRobot/Bee Robot (2022 Design)/Hardware(Electronic)/Autodesk Eagle/RoboBee_Keypad/v1.2/RoboBee_keypad.brd

## EAGLE design BeeRobot/Bee Robot (2022 Design)/Hardware(Electronic)/Autodesk Eagle/RoboBee_Keypad/v1.2/RoboBee_keypad.brd (2023-08-09)

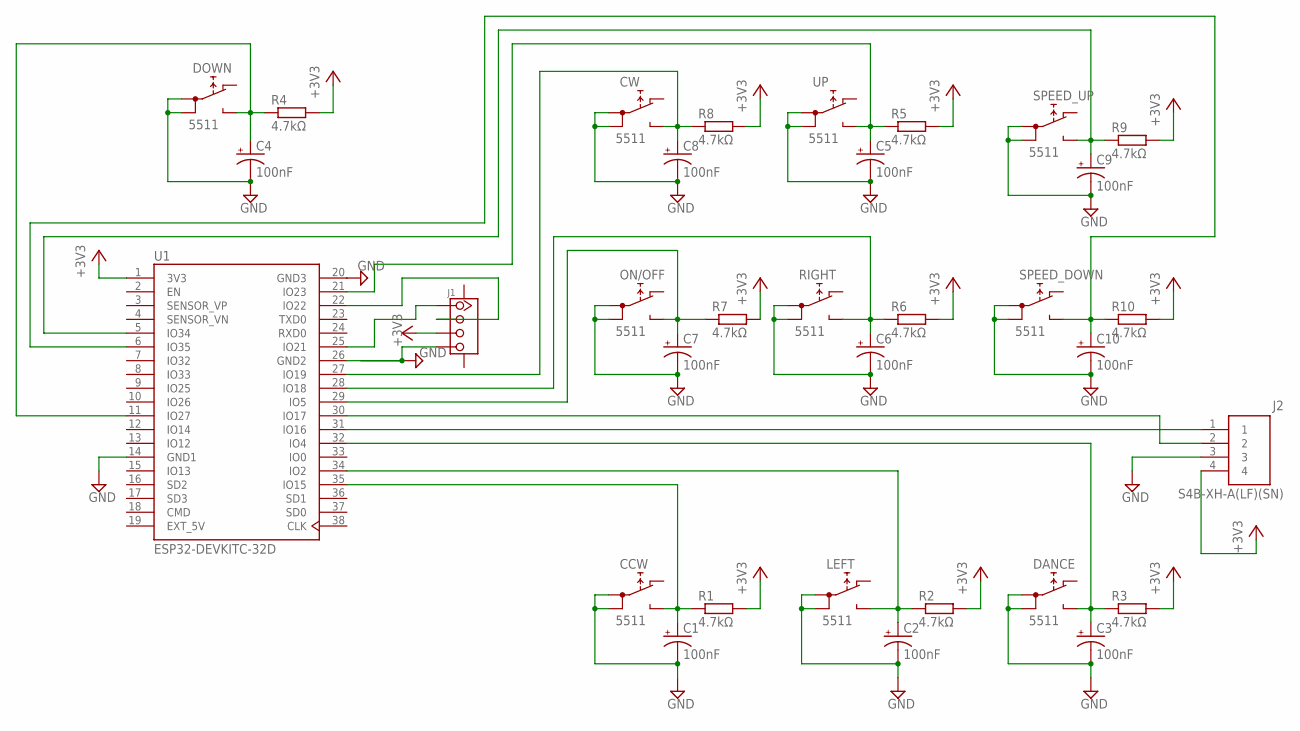
[picture p24: schematic RoboBee_keypad.sch]

Parts:
C1, C2, C3, C4, C5, C6, C7, C8, C9, C10: 100nF; E1,8-4
CCW: 5511
CW: 5511
DANCE: 5511
DOWN: 5511
J1: CONNECTOR_TWIG-4P-2.0-SMD-FEMALE-REINFORCE; CONNECTOR_4P-SMD-2.0-90D-W/O-BUCKLE
J2: S4B-XH-A(LF)(SN); HDR-04/RA
LEFT: 5511
ON/OFF: 5511
R1, R2, R3, R4, R5, R6, R7, R8, R9, R10: 4.7kΩ; 0207/10
RIGHT: 5511
SPEED_DOWN: 5511
SPEED_UP: 5511
U1: ESP32-DEVKITC-32D; MODULE_ESP32-DEVKITC-32D
UP: 5511

Connections:
+3V3: J1.3, J2.4, R1.2, R2.2, R3.2, R4.2, R5.2, R6.2, R7.2, R8.2, R9.2, R10.2, U1.1 (3V3)
EXT_5V: U1.19 (EXT_5V)
GND: C1.-, C2.-, C3.-, C4.-, C5.-, C6.-, C7.-, C8.-, C9.-, C10.-, CCW.1A, CCW.1B, CW.1A, CW.1B, DANCE.1A, DANCE.1B, DOWN.1A, DOWN.1B, J1.4, J2.3, LEFT.1A, LEFT.1B, ON/OFF.1A, ON/OFF.1B, RIGHT.1A, RIGHT.1B, SPEED_DOWN.1A, SPEED_DOWN.1B, SPEED_UP.1A, SPEED_UP.1B, U1.14 (GND1), U1.20 (GND3), U1.26 (GND2), UP.1A, UP.1B
unnamed: C1.+, CCW.NO, R1.1, U1.35 (IO15)
unnamed: C2.+, LEFT.NO, R2.1, U1.34 (IO2)
unnamed: C3.+, DANCE.NO, R3.1, U1.32 (IO4)
unnamed: C4.+, DOWN.NO, R4.1, U1.11 (IO27)
unnamed: C5.+, R5.1, U1.21 (IO23), UP.NO
unnamed: C6.+, R6.1, RIGHT.NO, U1.28 (IO18)
unnamed: C8.+, CW.NO, R8.1, U1.27 (IO19)
unnamed: C7.+, ON/OFF.NO, R7.1, U1.29 (IO5)
unnamed: C10.+, R10.1, SPEED_DOWN.NO, U1.6 (IO35)
unnamed: J1.1, U1.25 (IO21)
unnamed: J2.1, U1.31 (IO16)
unnamed: J2.2, U1.30 (IO17)
unnamed: J1.2, U1.22 (IO22)
unnamed: C9.+, R9.1, SPEED_UP.NO, U1.5 (IO34)

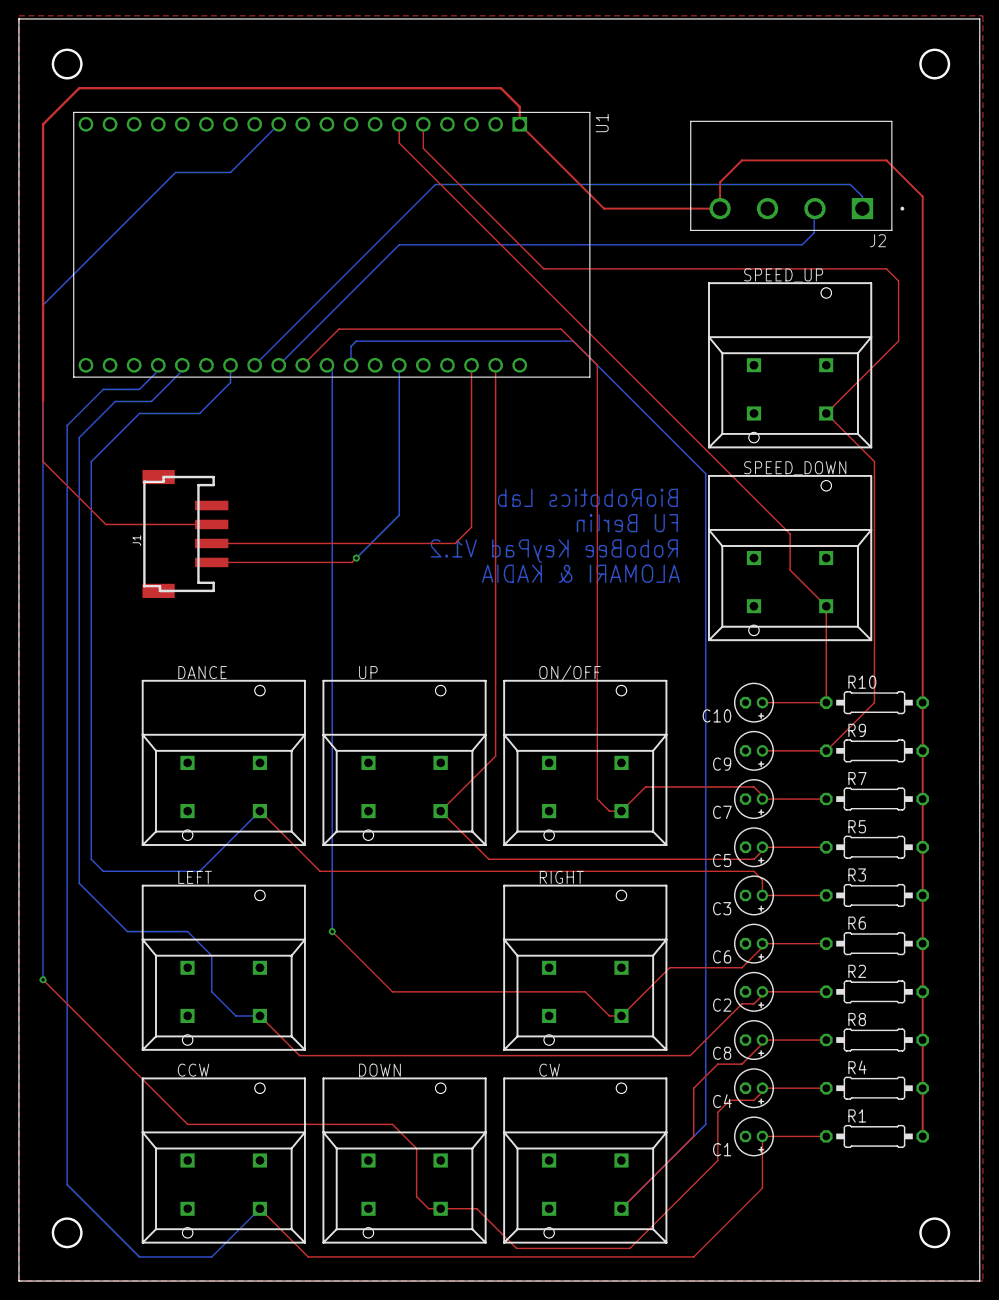
[picture p25: board RoboBee_keypad.brd from above]

Board: 2 copper layers, 101.3 x 133.0 mm, 33 parts (0 on the bottom side), 16 nets.
