BioroboticsLab/hiveopolis_dance_robot/(commit log)

2023-08-09 Added STL hardware files for Lights and camera fixture and mounts.
    [Axis_Change_Connector.stl, M5_Knob_Short.stl, Mount_Arm_Straight_30mm.STL, Mount_Arm_Straight_60mm.STL, Mount_Flat_Fix_Item.stl, Mount_Flat_Fix_Light.stl, Mount_Raspberry_Pi_CameraFRONT.stl]
2023-08-09 Adding 3D Models of the ITEM Robot Fixture
    [Robot_ITEM_Fixture.STEP]
2023-08-09 Added Encoder Code
2023-08-09 Bee Robot Electronic Hardware files added
    [Hiveopolis.brd, Hiveopolis.sch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]
2023-08-09 Folder reorganization
    Folder reorganization to create two versions of the Bee Robot i.e. 2022 version being the first one and the second one being the repurposed 3d plotter
    [Hiveopolis.brd, Hiveopolis.sch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]
2023-08-09 Added code for Main Board 2022 version
2023-08-09 Added CAD Files for the Bee Robot
    Added CAD Files for the Bee Robot for version 2022
    [Bill Materials Combined.xlsx, Keypad_D_Cover.stl, Keypad_UP_Cover.stl, ShaftholdersAndGuide.stl, bee_artificial_v5 v4.f3z, bee_artificial_v5 v4.step, bee_artificial_v5 v4.stl, bee_artificial_v6 v1.f3z]
